JAPS01/4Axes_CNC_ESP32/ESPCNC Conexiones.pptx

CNC ESP32 BOARD

Vin 12V TO 60V

Pause

Micro SD-Card

USB C

End_Stop

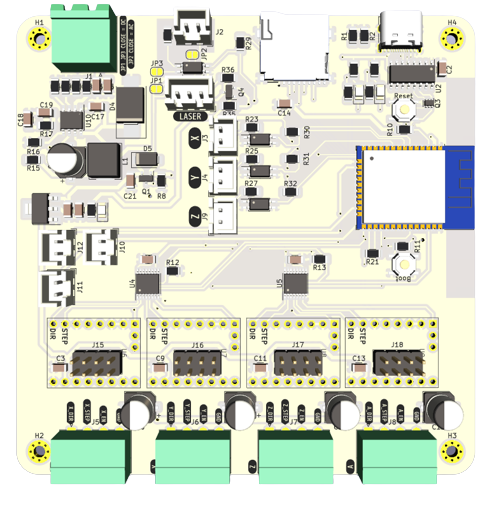
[picture p1: figure]

External Motor Driver MODE

IO12

IO13

IO15

X

Y

Z

A

DIR

STEP

EN

GND

DIR

STEP

EN

GND

DIR

STEP

EN

GND

DIR

STEP

EN

GND

## Slide 2

CNC ESP32 BOARD

Vin 12V TO 60V

Pause

Micro SD-Card

USB C

End_Stop

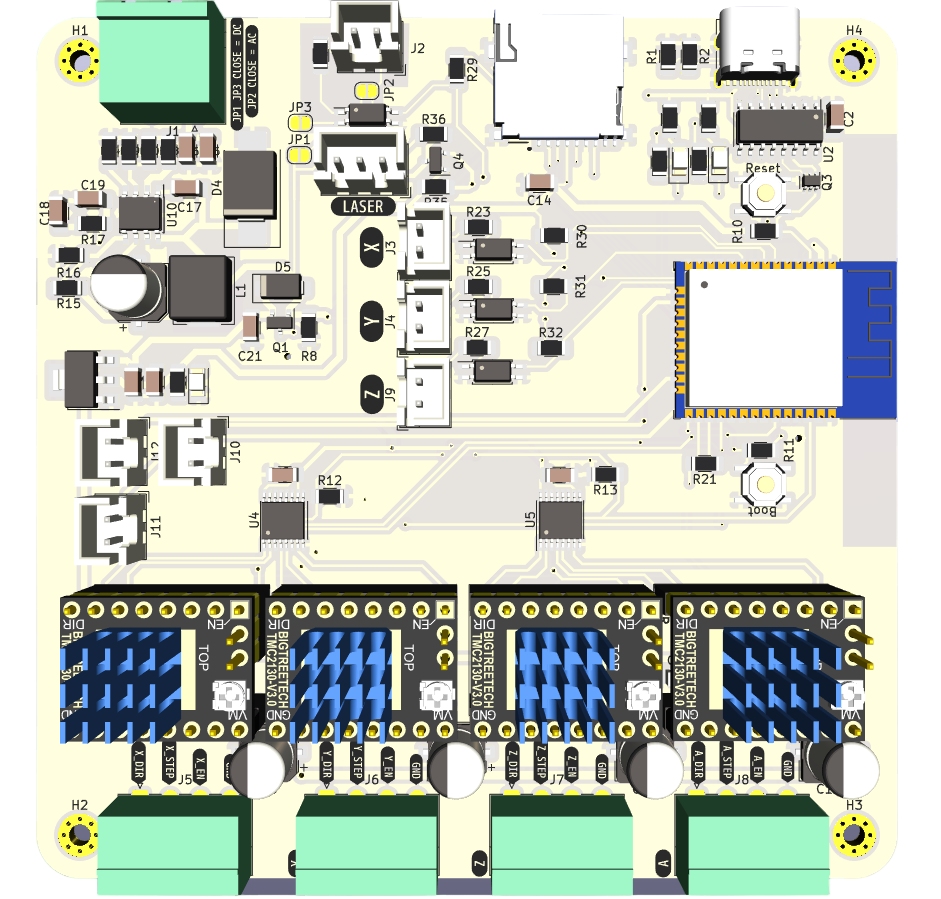
[picture p2: figure]

IO12

IO13

IO15

X

Y

Z

A

TMC2209 MODE

Step Motor
