JAPS01/4Axes_CNC_ESP32/DXF/80X80.dxf

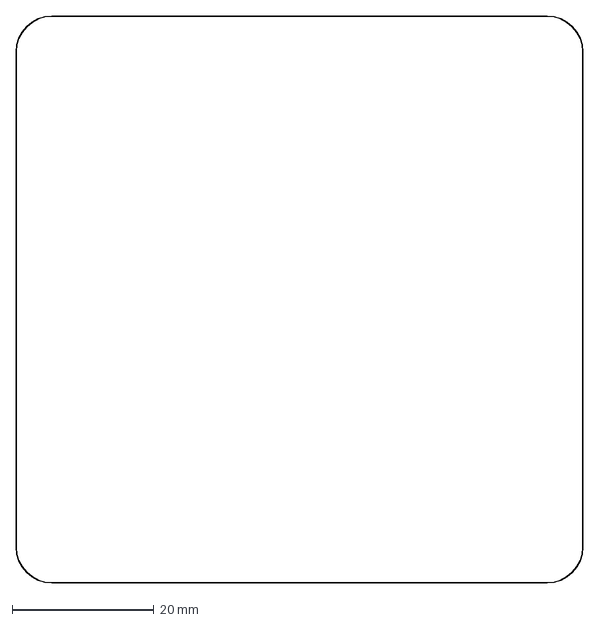
[picture p3: CAD file, 2023-11-01]
DXF/80X80.dxf
80.0 x 80.0 mm
