JAPS01/4Axes_CNC_ESP32/DXF/100X80.dxf

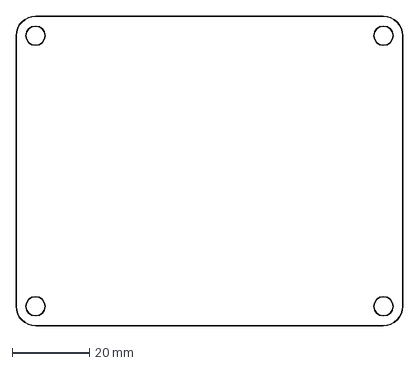
[picture p4: CAD file, 2023-11-01]
DXF/100X80.dxf
100.0 x 80.0 mm
