JAPS01/4Axes_CNC_ESP32/DXF/120X80.dxf

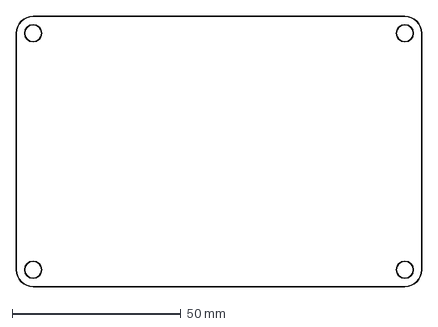
[picture p5: CAD file, 2023-11-01]
DXF/120X80.dxf
120.0 x 80.0 mm
