JAPS01/4Axes_CNC_ESP32/DXF/100X100.dxf

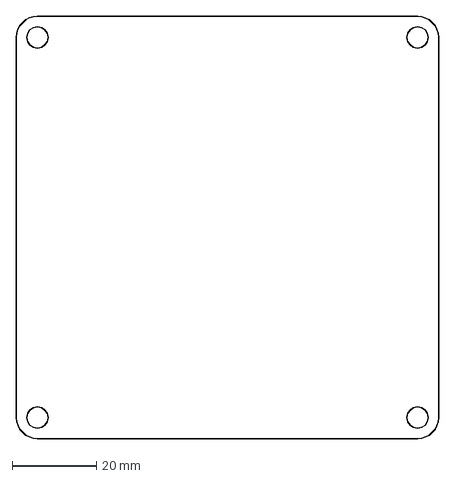
[picture p6: CAD file, 2023-11-01]
DXF/100X100.dxf
100.0 x 100.0 mm
