JAPS01/4Axes_CNC_ESP32/ESP32_CNC.kicad_pcb

## KiCad design ESP32_CNC.kicad_pcb (2023-11-01)

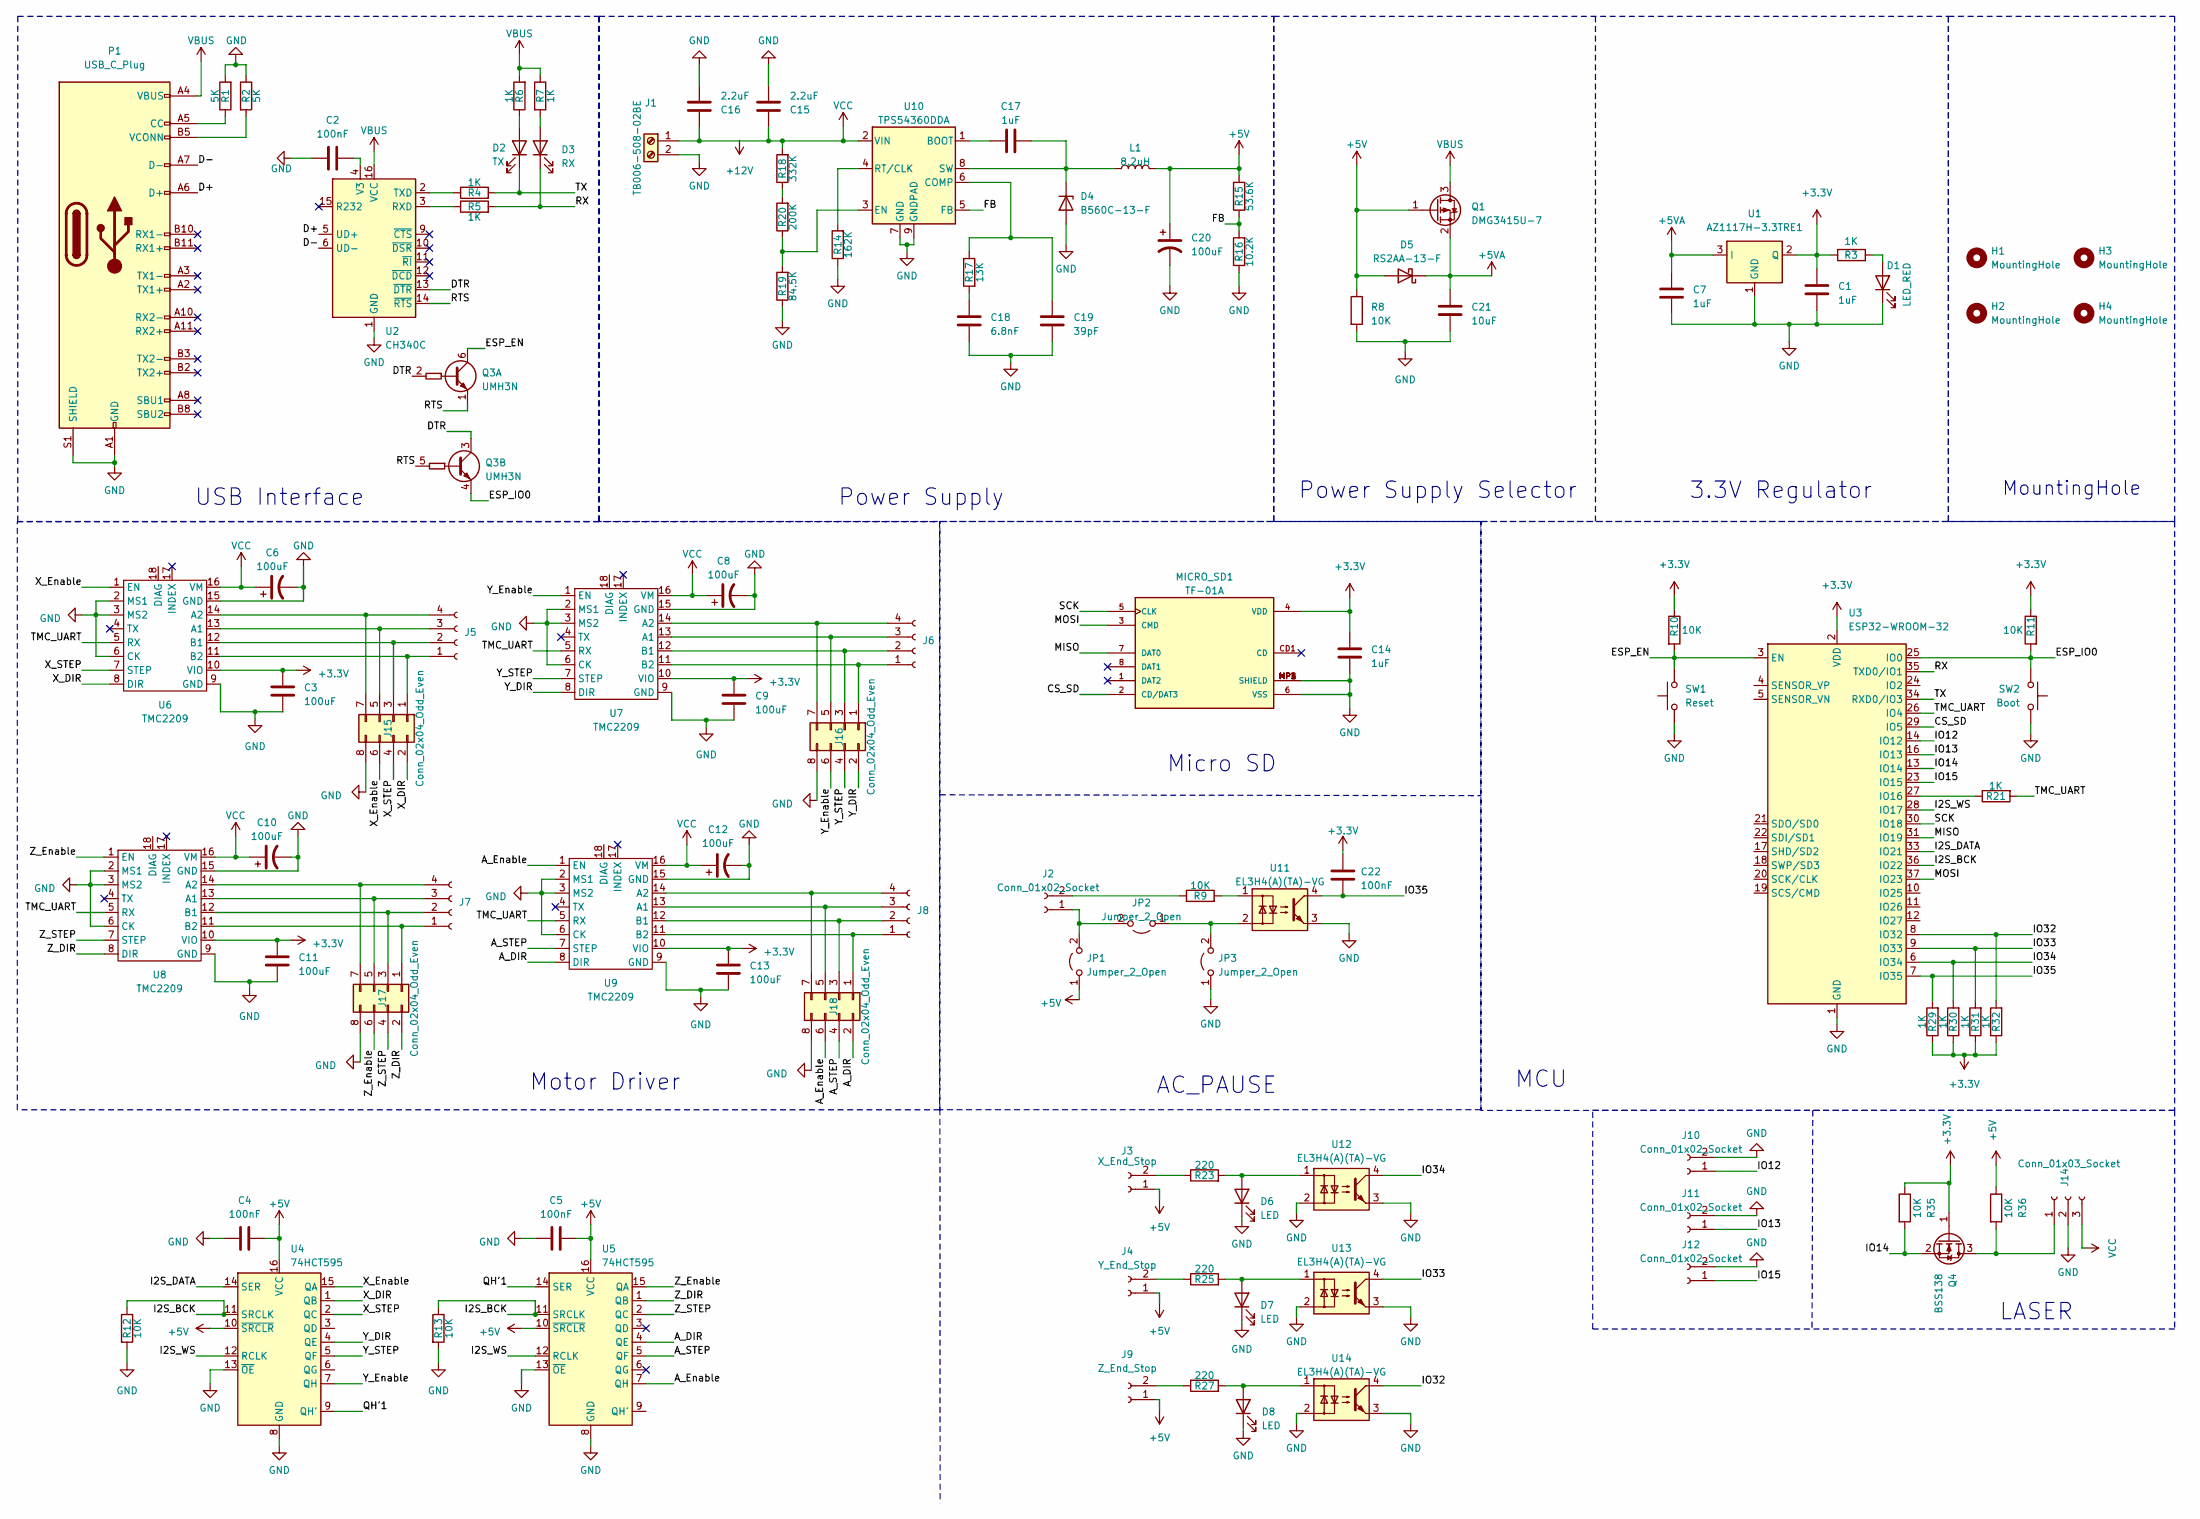
[picture p7: schematic ESP32_CNC.kicad_sch, ESP32_FLUID_BOARD]

Parts:
C1, C7, C14, C17: 1uF; C_1206_3216Metric_Pad1.33x1.80mm_HandSolder; LCSC C107185
C2, C4, C5, C22: 100nF; C_1206_3216Metric_Pad1.33x1.80mm_HandSolder; LCSC C82601
C3, C9, C11, C13: 100uF; C_1206_3216Metric_Pad1.33x1.80mm_HandSolder; LCSC C110048
C6, C8, C10, C12, C20: 100uF; CP_Elec_6.3x7.7; LCSC C178560
C15, C16: 2.2uF; C_1206_3216Metric_Pad1.33x1.80mm_HandSolder; LCSC C113893
C18: 6.8nF; C_1206_3216Metric_Pad1.33x1.80mm_HandSolder; LCSC C527325
C19: 39pF; C_1206_3216Metric_Pad1.33x1.80mm_HandSolder; LCSC C326958
C21: 10uF; C_1206_3216Metric_Pad1.33x1.80mm_HandSolder; LCSC C70462
D1: LED_RED; LED_1206_3216Metric_Pad1.42x1.75mm_HandSolder; LCSC C965827
D2: TX; LED_1206_3216Metric_Pad1.42x1.75mm_HandSolder; LCSC C965827
D3: RX; LED_1206_3216Metric_Pad1.42x1.75mm_HandSolder; LCSC C965827
D4: B560C-13-F; D_SMC_Handsoldering; LCSC C85100
D5: RS2AA-13-F; D_SMA
D6, D7, D8: LED; LED_1206_3216Metric_Pad1.42x1.75mm_HandSolder
H1, H2, H3, H4: MountingHole; MountingHole_2.5mm_Pad_Via
J1: TB006-508-02BE; PhoenixContact_MSTBA_2,5_2-G_1x02_P5.00mm_Horizontal; LCSC C505815
J2, J10, J11, J12: Conn_01x02_Socket; JST_XH_B2B-XH-A_1x02_P2.50mm_Vertical; LCSC C158012
J3: X_End_Stop; JST_XH_B2B-XH-A_1x02_P2.50mm_Vertical; LCSC C158012
J4: Y_End_Stop; JST_XH_B2B-XH-A_1x02_P2.50mm_Vertical; LCSC C158012
J5, J6, J7, J8: Conn_01x04_Socket; PhoenixContact_MC_1,5_4-G-3.5_1x04_P3.50mm_Horizontal; LCSC C441173
J9: Z_End_Stop; JST_XH_B2B-XH-A_1x02_P2.50mm_Vertical; LCSC C158012
J14: Conn_01x03_Socket; JST_XH_B3B-XH-A_1x03_P2.50mm_Vertical
J15, J16, J17, J18: Conn_02x04_Odd_Even; PinHeader_2x04_P2.54mm_Vertical
JP1, JP2, JP3: Jumper_2_Open; SolderJumper-2_P1.3mm_Open_RoundedPad1.0x1.5mm
L1: 8.2uH; L_Chilisin_BMRx00060630; LCSC C5349707
MICRO_SD1: TF-01A; LCSC C91145
P1: USB_C_Plug; USB_C_Receptacle_XKB_U262-16XN-4BVC11; LCSC C319148
Q1: DMG3415U-7; SOT-23; LCSC C96616
Q3: UMH3N; SOT-363_SC-70-6; LCSC C62892
Q4: BSS138; SOT-23
R1, R2: 5K; R_1206_3216Metric_Pad1.30x1.75mm_HandSolder; LCSC C870818
R3, R4, R5, R6, R7, R21, R29, R30, R31, R32: 1K; R_1206_3216Metric_Pad1.30x1.75mm_HandSolder; LCSC C112223
R8, R10, R11, R12, R13, R35, R36: 10K; R_1206_3216Metric_Pad1.30x1.75mm_HandSolder; LCSC C132649
R9: 10K; R_1206_3216Metric_Pad1.30x1.75mm_HandSolder
R14: 162K; R_1206_3216Metric_Pad1.30x1.75mm_HandSolder; LCSC C229338
R15: 53.6K; R_1206_3216Metric_Pad1.30x1.75mm_HandSolder; LCSC C229697
R16: 10.2K; R_1206_3216Metric_Pad1.30x1.75mm_HandSolder; LCSC C229274
R17: 13K; R_1206_3216Metric_Pad1.30x1.75mm_HandSolder; LCSC C229313
R18: 332K; R_1206_3216Metric_Pad1.30x1.75mm_HandSolder; LCSC C229555
R19: 84.5K; R_1206_3216Metric_Pad1.30x1.75mm_HandSolder; LCSC C229820
R20: 200K; R_1206_3216Metric_Pad1.30x1.75mm_HandSolder; LCSC C114937
R23, R25, R27: 220; R_1206_3216Metric_Pad1.30x1.75mm_HandSolder; LCSC C137176
SW1: Reset; JT1140; LCSC C465061
SW2: Boot; JT1140; LCSC C465061
U1: AZ1117H-3.3TRE1; SOT-223; LCSC C92517
U2: CH340C; SOIC-16_3.9x9.9mm_P1.27mm; LCSC C84681
U3: ESP32-WROOM-32
U4, U5: 74HCT595; TSSOP-16_4.4x5mm_P0.65mm; LCSC C842461
U6, U7, U8, U9: TMC2209
U10: TPS54360DDA; TI_SO-PowerPAD-8_ThermalVias; LCSC C44377
U11, U12, U13, U14: EL3H4(A)(TA)-VG; SOP-4_4.4x2.6mm_P1.27mm; LCSC C142289

Connections:
+3.3V: C1.1, C3.2, C9.2, C11.2, C13.2, C14.1, C22.2, MICRO_SD1.4 (VDD), Q4.1 (G), R3.1, R10.1, R11.1, R29.1, R30.1, R31.1, R32.1, R35.1, U1.2 (Q), U3.2 (VDD), U6.10 (VIO), U7.10 (VIO), U8.10 (VIO), U9.10 (VIO)
+5V: C4.2, C5.2, C20.1, D5.2 (A), J3.1, J4.1, J9.1, JP1.1 (A), L1.2, Q1.1 (G), R8.1, R15.2, R36.1, U4.10 (~SRCLR), U4.16 (VCC), U5.10 (~SRCLR), U5.16 (VCC)
+5VA: C7.1, C21.1, D5.1 (K), Q1.2 (S), U1.3 (I)
/A_DIR: J18.2, U5.4 (QE), U9.8 (DIR)
/A_Enable: J18.6, U5.7 (QH), U9.1 (EN)
/A_STEP: J18.4, U5.5 (QF), U9.7 (STEP)
/CS_SD: MICRO_SD1.2 (CD/DAT3), U3.29 (IO5)
/D+: P1.A6 (D+), U2.5 (UD+)
/D-: P1.A7 (D-), U2.6 (UD-)
/DTR: Q3.2 (B1), Q3.3 (C2), U2.13 (~DTR)
/ESP_EN: Q3.6 (C1), R10.2, SW1.2, U3.3 (EN)
/ESP_IO0: Q3.4 (E2), R11.2, SW2.2, U3.25 (IO0)
/FB: R15.1, R16.2, U10.5 (FB)
/I2S_BCK: R12.1, R13.1, U3.36 (IO22), U4.11 (SRCLK), U5.11 (SRCLK)
/I2S_DATA: U3.33 (IO21), U4.14 (SER)
/I2S_WS: U3.28 (IO17), U4.12 (RCLK), U5.12 (RCLK)
/IO12: J10.1, U3.14 (IO12)
/IO13: J11.1, U3.16 (IO13)
/IO14: Q4.2 (S), R35.2, U3.13 (IO14)
/IO15: J12.1, U3.23 (IO15)
/IO32: R32.2, U3.8 (IO32), U14.4
/IO33: R31.2, U3.9 (IO33), U13.4
/IO34: R30.2, U3.6 (IO34), U12.4
/IO35: C22.1, R29.2, U3.7 (IO35), U11.4
/MISO: MICRO_SD1.7 (DAT0), U3.31 (IO19)
/MOSI: MICRO_SD1.3 (CMD), U3.37 (IO23)
/QH'1: U4.9 (QH'), U5.14 (SER)
/RTS: Q3.1 (E1), Q3.5 (B2), U2.14 (~RTS)
/RX: D3.1 (K), R5.2, U3.35 (TXD0/IO1)
/SCK: MICRO_SD1.5 (CLK), U3.30 (IO18)
/TMC_UART: R21.2, U3.26 (IO4), U6.5 (RX), U7.5 (RX), U8.5 (RX), U9.5 (RX)
/TX: D2.1 (K), R4.2, U3.34 (RXD0/IO3)
/X_DIR: J15.2, U4.1 (QB), U6.8 (DIR)
/X_Enable: J15.6, U4.15 (QA), U6.1 (EN)
/X_STEP: J15.4, U4.2 (QC), U6.7 (STEP)
/Y_DIR: J16.2, U4.4 (QE), U7.8 (DIR)
/Y_Enable: J16.6, U4.7 (QH), U7.1 (EN)
/Y_STEP: J16.4, U4.5 (QF), U7.7 (STEP)
/Z_DIR: J17.2, U5.1 (QB), U8.8 (DIR)
/Z_Enable: J17.6, U5.15 (QA), U8.1 (EN)
/Z_STEP: J17.4, U5.2 (QC), U8.7 (STEP)
GND: C1.2, C2.1, C3.1, C4.1, C5.1, C6.2, C7.2, C8.2, C9.1, C10.2, C11.1, C12.2, C13.1, C14.2, C15.2, C16.2, C18.2, C19.1, C20.2, C21.2, D1.1 (K), D4.2 (A), D6.1 (K), D7.1 (K), D8.1 (K), J1.2, J10.2, J11.2, J12.2, J14.2, J15.8, J16.8, J17.8, J18.8, JP3.1 (A), MICRO_SD1.6 (VSS), MICRO_SD1.MP1 (SHIELD), MICRO_SD1.MP2 (SHIELD), MICRO_SD1.MP3 (SHIELD), MICRO_SD1.MP4 (SHIELD), P1.A1 (GND), P1.A12 (GND), P1.B1 (GND), P1.B12 (GND), P1.S1 (SHIELD), R1.2, R2.1, R8.2, R12.2, R13.2, R14.1, R16.1, R19.1, SW1.1, SW2.1, U1.1 (GND), U2.1 (GND), U3.1 (GND), U3.15 (GND), U3.38 (GND), U3.39 (GND), U4.8 (GND), U4.13 (~OE), U5.8 (GND), U5.13 (~OE), U6.2 (MS1), U6.3 (MS2), U6.6 (CK), U6.9 (GND), U6.15 (GND), U7.2 (MS1), U7.3 (MS2), U7.6 (CK), U7.9 (GND), U7.15 (GND), U8.2 (MS1), U8.3 (MS2), U8.6 (CK), U8.9 (GND), U8.15 (GND), U9.2 (MS1), U9.3 (MS2), U9.6 (CK), U9.9 (GND), U9.15 (GND), U10.7 (GND), U10.9 (GNDPAD), U11.3, U12.2, U12.3, U13.2, U13.3, U14.2, U14.3
unnamed: C18.1, R17.2
unnamed: D1.2 (A), R3.2
unnamed: D2.2 (A), R6.1
unnamed: D3.2 (A), R7.2
unnamed: C17.2, D4.1 (K), L1.1, U10.8 (SW)
unnamed: D6.2 (A), R23.2, U12.1
unnamed: D7.2 (A), R25.2, U13.1
unnamed: D8.2 (A), R27.2, U14.1
unnamed: J2.1, JP1.2 (B), JP2.2 (B)
unnamed: J2.2, R9.1
unnamed: J3.2, R23.1
unnamed: J4.2, R25.1
unnamed: J9.2, R27.1
unnamed: J14.1, Q4.3 (D), R36.2
unnamed: J5.1, J15.1, U6.11 (B2)
unnamed: J5.2, J15.3, U6.12 (B1)
unnamed: J5.3, J15.5, U6.13 (A1)
unnamed: J5.4, J15.7, U6.14 (A2)
unnamed: J6.1, J16.1, U7.11 (B2)
unnamed: J6.2, J16.3, U7.12 (B1)
unnamed: J6.3, J16.5, U7.13 (A1)
unnamed: J6.4, J16.7, U7.14 (A2)
unnamed: J7.1, J17.1, U8.11 (B2)
unnamed: J7.2, J17.3, U8.12 (B1)
unnamed: J7.3, J17.5, U8.13 (A1)
unnamed: J7.4, J17.7, U8.14 (A2)
unnamed: J8.1, J18.1, U9.11 (B2)
unnamed: J8.2, J18.3, U9.12 (B1)
unnamed: J8.3, J18.5, U9.13 (A1)
unnamed: J8.4, J18.7, U9.14 (A2)
unnamed: JP2.1 (A), JP3.2 (B), U11.2
unnamed: P1.A5 (CC), R1.1
unnamed: P1.B5 (VCONN), R2.2
unnamed: R9.2, U11.1
unnamed: R18.1, R20.2
unnamed: R5.1, U2.3 (RXD)
unnamed: R4.1, U2.2 (TXD)
unnamed: C2.2, U2.4 (V3)
unnamed: R21.1, U3.27 (IO16)
unnamed: C17.1, U10.1 (BOOT)
unnamed: C19.2, R17.1, U10.6 (COMP)
unnamed: R19.2, R20.1, U10.3 (EN)
unnamed: R14.2, U10.4 (RT/CLK)
VBUS: P1.A4 (VBUS), P1.A9 (VBUS), P1.B4 (VBUS), P1.B9 (VBUS), Q1.3 (D), R6.2, R7.1, U2.16 (VCC)
VCC: C6.1, C8.1, C10.1, C12.1, C15.1, C16.1, J1.1, J14.3, R18.2, U6.16 (VM), U7.16 (VM), U8.16 (VM), U9.16 (VM), U10.2 (VIN)

Notes on the sheet:
MCU
Motor Driver
AC_PAUSE
USB Interface
Micro SD
LASER
MountingHole
3.3V Regulator
Power Supply
Power Supply Selector

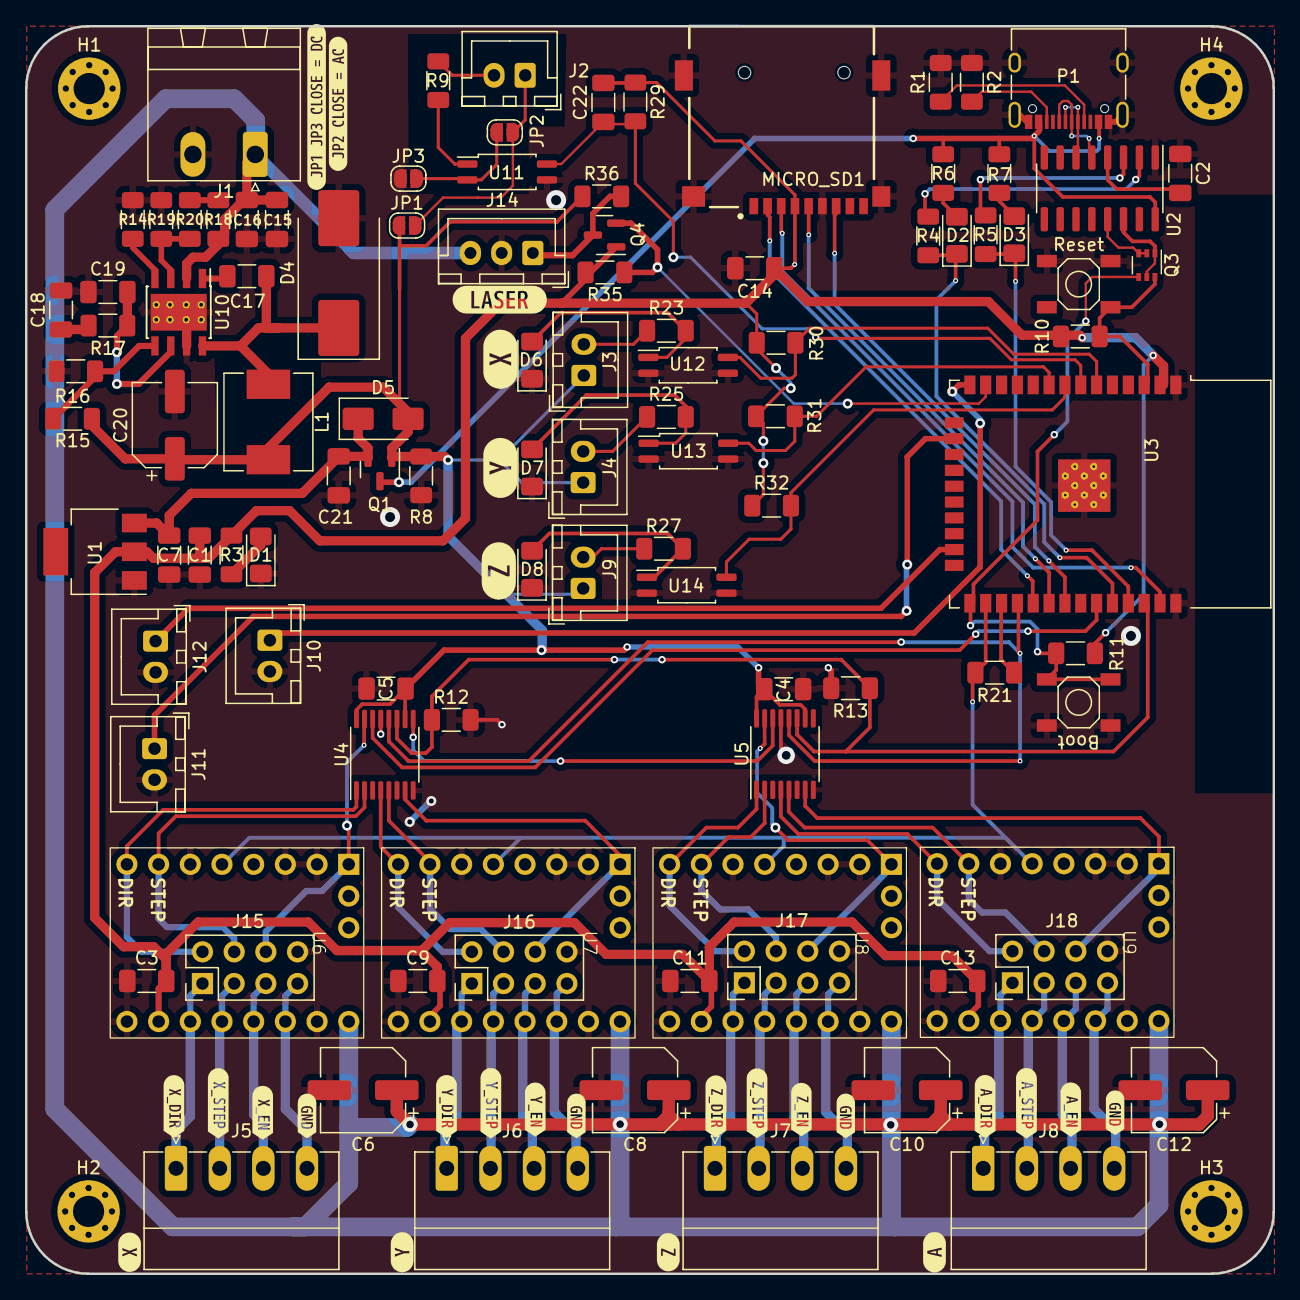
[picture p8: board ESP32_CNC.kicad_pcb from above]

Board: 2 copper layers, 100.0 x 100.0 mm, 132 parts (0 on the bottom side), 87 nets.

Other parts of the board:
kibuzzard-64A8D498: G***; kibuzzard-64A8D498
kibuzzard-64A9FD55: G***; kibuzzard-64A9FD55
kibuzzard-64A9FD75: G***; kibuzzard-64A9FD75
kibuzzard-64AA0C0E: G***; kibuzzard-64AA0C0E
kibuzzard-64AA0C1E: G***; kibuzzard-64AA0C1E
kibuzzard-64AA0C27: G***; kibuzzard-64AA0C27
kibuzzard-64AA3047: G***; kibuzzard-64AA3047
kibuzzard-64AF2DE8: G***; kibuzzard-64AF2DE8
kibuzzard-64AF2E2C: G***; kibuzzard-64AF2E2C
kibuzzard-64AF2E5B: G***; kibuzzard-64AF2E5B
kibuzzard-64AF2E13: G***; kibuzzard-64AF2E13
kibuzzard-64AF2E33, kibuzzard-64AF2E33#2, kibuzzard-64AF2E33#3, kibuzzard-64AF2E33#4: G***; kibuzzard-64AF2E33
kibuzzard-64AF2E65: G***; kibuzzard-64AF2E65
kibuzzard-64AF2EE8: G***; kibuzzard-64AF2EE8
kibuzzard-64AF2EF3: G***; kibuzzard-64AF2EF3
kibuzzard-64AF2EFB: G***; kibuzzard-64AF2EFB
kibuzzard-64AF2F0A: G***; kibuzzard-64AF2F0A
kibuzzard-64AF2F1D: G***; kibuzzard-64AF2F1D
kibuzzard-64AF2F02: G***; kibuzzard-64AF2F02
kibuzzard-64AF2F11: G***; kibuzzard-64AF2F11
kibuzzard-64AF2FB1: G***; kibuzzard-64AF2FB1
kibuzzard-64AF2FF1: G***; kibuzzard-64AF2FF1
kibuzzard-64AF3027: G***; kibuzzard-64AF3027
