JAPS01/4Axes_CNC_ESP32/firmware/Custom FluidNC/Config.yaml

name: "ESP32 Dev Controller V4"
board: "ESP32 Dev Controller V4"
meta: "update for 3.6.8"

stepping:
  engine: RMT
  idle_ms: 250
  dir_delay_us: 1
  pulse_us: 2
  disable_delay_us: 0
  
uart1:
  txd_pin: NO_PIN
  rxd_pin: gpio.16
  rts_pin: NO_PIN
  cts_pin: NO_PIN
  baud: 115200
  mode: 8N1

axes:
  shared_stepper_disable_pin: NO_PIN
  
  x:
    steps_per_mm: 800
    max_rate_mm_per_min: 5000
    acceleration_mm_per_sec2: 100
    max_travel_mm: 300
    homing:
      cycle: 1
      mpos_mm: 150
      positive_direction: false
      feed_mm_per_min: 100.000
      seek_mm_per_min: 200.000
      settle_ms: 500
    
    motor0:
      limit_neg_pin: gpio.34:low
      tmc_2209:
        uart_num: 1
        addr: 0
        cs_pin: NO_PIN
        r_sense_ohms: 0.110
        run_amps: 1.000
        hold_amps: 0.500
        microsteps: 16
        stallguard: 0
        stallguard_debug: false
        toff_disable: 0
        toff_stealthchop: 5
        toff_coolstep: 3
        run_mode: StealthChop
        homing_mode: StealthChop
        use_enable: false
        direction_pin: I2SO.1
        step_pin: I2SO.2
        disable_pin: I2SO.0:low

    motor1:
      null_motor:

  y:
    steps_per_mm: 100.000
    max_rate_mm_per_min: 5000.000
    acceleration_mm_per_sec2: 100.000
    max_travel_mm: 300.000
    soft_limits: false
    homing:
      cycle: 3
      positive_direction: false
      mpos_mm: 0.000
      feed_mm_per_min: 100.000
      seek_mm_per_min: 200.000
      settle_ms: 500
      seek_scaler: 1.100
      feed_scaler: 1.100

    motor0:
      limit_neg_pin: gpio.33:low
      limit_pos_pin: NO_PIN
      limit_all_pin: NO_PIN
      hard_limits: false
      pulloff_mm: 1.000
      standard_stepper:
        step_pin: I2SO.5
        direction_pin: I2SO.4
        disable_pin: I2SO.7:low

  z:
    steps_per_mm: 100.000
    max_rate_mm_per_min: 5000.000
    acceleration_mm_per_sec2: 100.000
    max_travel_mm: 150.000
    soft_limits: false
    homing:
      cycle: 1
      positive_direction: true
      mpos_mm: 150.000
      feed_mm_per_min: 100.000
      seek_mm_per_min: 800.000
      settle_ms: 500
      seek_scaler: 1.100
      feed_scaler: 1.100

    motor0:
      limit_neg_pin: gpio.32:low
      limit_pos_pin: NO_PIN
      limit_all_pin: NO_PIN
      hard_limits: false
      pulloff_mm: 1.000
      standard_stepper:
        step_pin: I2SO.10
        direction_pin: I2SO.9
        disable_pin: I2SO.8:low

  a:
    steps_per_mm: 100.000
    max_rate_mm_per_min: 5000.000
    acceleration_mm_per_sec2: 100.000
    max_travel_mm: 150.000
    soft_limits: false
    homing:
      cycle: 1
      positive_direction: true
      mpos_mm: 150.000
      feed_mm_per_min: 100.000
      seek_mm_per_min: 800.000
      settle_ms: 500
      seek_scaler: 1.100
      feed_scaler: 1.100

    motor0:
      limit_neg_pin: NO_PIN
      limit_pos_pin: NO_PIN
      limit_all_pin: NO_PIN
      hard_limits: false
      pulloff_mm: 1.000
      standard_stepper:
        step_pin: I2SO.13
        direction_pin: I2SO.12
        disable_pin: I2SO.15:low
      
i2so:
  bck_pin: gpio.22
  data_pin: gpio.21
  ws_pin: gpio.17

spi:
  miso_pin: gpio.19
  mosi_pin: gpio.23
  sck_pin: gpio.18

sdcard:
  card_detect_pin: NO_PIN
  cs_pin: gpio.5

start:
  must_home: false

control:
  safety_door_pin: gpio.35:high

Laser:
  pwm_hz: 5000
  output_pin: gpio.14
  enable_pin: NO_PIN
  disable_with_s0: false
  s0_with_disable: false
  tool_num: 0
  speed_map: 0=0.000% 255=100.000%
  off_on_alarm: true
