JAPS01/4Axes_CNC_ESP32/firmware/FluidNC-main/example_configs/3axis_v4.yaml

name: "ESP32 Dev Controller V4"
board: "ESP32 Dev Controller V4"

stepping:
  engine: RMT
  idle_ms: 250
  dir_delay_us: 1
  pulse_us: 2
  disable_delay_us: 0

axes:
  shared_stepper_disable_pin: gpio.13:low
  
  x:
    steps_per_mm: 800
    max_rate_mm_per_min: 2000
    acceleration_mm_per_sec2: 25
    max_travel_mm: 1000
    homing:
      cycle: 2
      mpos_mm: 10
      positive_direction: false
    
    motor0:
      limit_all_pin: gpio.17:low:pu
      stepstick:
        direction_pin: gpio.14
        step_pin: gpio.12
    motor1:
      null_motor:

  y:
    steps_per_mm: 800
    max_rate_mm_per_min: 2000
    acceleration_mm_per_sec2: 25
    max_travel_mm: 1000
    homing:
      cycle: 2
      mpos_mm: 10
      positive_direction: false

    motor0:
      limit_all_pin: gpio.4:low:pu
      stepstick:
        direction_pin: gpio.15
        step_pin: gpio.26
    motor1:
      null_motor:

  z:
    steps_per_mm: 800
    max_rate_mm_per_min: 2000
    acceleration_mm_per_sec2: 25
    max_travel_mm: 1000
    homing:
      cycle: 1
      mpos_mm: 10
      positive_direction: true

    motor0:
      limit_all_pin: gpio.16:low:pu
      stepstick:
        direction_pin: gpio.33
        step_pin: gpio.27
    motor1:
      null_motor:

spi:
  miso_pin: gpio.19
  mosi_pin: gpio.23
  sck_pin: gpio.18

sdcard:
  cs_pin: gpio.5
  card_detect_pin: NO_PIN

coolant:
  flood_pin: gpio.25
  mist_pin:  gpio.21

        
probe:
  pin: gpio.32:low:pu

PWM:
  pwm_hz: 5000
  output_pin: gpio.2
  enable_pin: gpio.22
  direction_pin: NO_PIN
  disable_with_s0: false
  s0_with_disable: true
  spinup_ms: 0
  spindown_ms: 0
  tool_num: 0
  speed_map: 0=0% 10000=100%
