JAPS01/4Axes_CNC_ESP32/firmware/FluidNC-main/example_configs/BlackBox_X32_XYYZ-DOOR.yaml

board: OpenBuilds BlackBox X32
name: BlackBox_X32_XYYZ-DOOR
meta: Handcrafted by Shell M Shrader
stepping:
  engine: RMT
  idle_ms: 255
  pulse_us: 2
  dir_delay_us: 1
  disable_delay_us: 0

axes:
  shared_stepper_disable_pin: gpio.17:low
  x:
    steps_per_mm: 200.000
    max_rate_mm_per_min: 1000.000
    acceleration_mm_per_sec2: 100.000
    max_travel_mm: 300.000
    soft_limits: false
    homing:
      cycle: 2
      feed_mm_per_min: 100.000
      seek_mm_per_min: 500.000
      settle_ms: 500
      seek_scaler: 1.100
      feed_scaler: 1.100

    motor0:
      limit_neg_pin: gpio.35
      limit_pos_pin: NO_PIN
      limit_all_pin: NO_PIN
      hard_limits: false
      pulloff_mm: 1.000
      standard_stepper:
        step_pin: gpio.12
        direction_pin: gpio.14

  y:
    steps_per_mm: 200.000
    max_rate_mm_per_min: 1000.000
    acceleration_mm_per_sec2: 100.000
    max_travel_mm: 300.000
    soft_limits: false
    homing:
      cycle: 2
      feed_mm_per_min: 100.000
      seek_mm_per_min: 500.000
      settle_ms: 500
      seek_scaler: 1.100
      feed_scaler: 1.100

    motor0:
      limit_neg_pin: gpio.34
      limit_pos_pin: NO_PIN
      limit_all_pin: NO_PIN
      hard_limits: false
      pulloff_mm: 1.000
      standard_stepper:
        step_pin: gpio.27
        direction_pin: gpio.26

    motor1:
      standard_stepper:
        step_pin: gpio.33
        direction_pin: gpio.32

  z:
    steps_per_mm: 200.000
    max_rate_mm_per_min: 300.000
    acceleration_mm_per_sec2: 100.000
    max_travel_mm: 50.000
    soft_limits: false
    homing:
      cycle: 1
      feed_mm_per_min: 100.000
      seek_mm_per_min: 200.000
      settle_ms: 500
      seek_scaler: 1.100
      feed_scaler: 1.100

    motor0:
      limit_neg_pin: gpio.39
      limit_pos_pin: NO_PIN
      limit_all_pin: NO_PIN
      hard_limits: false
      pulloff_mm: 1.000
      standard_stepper:
        step_pin: gpio.15
        direction_pin: gpio.2

spi:
  miso_pin: gpio.19
  mosi_pin: gpio.23
  sck_pin: gpio.18

sdcard:
  card_detect_pin: NO_PIN
  cs_pin: gpio.5

probe:
  pin: gpio.22:low
  check_mode_start: true

control:
  safety_door_pin: gpio.16:pu

macros:
  startup_line0:
  startup_line1:
  macro0:
  macro1:
  macro2:
  macro3:

start:
  must_home: false

coolant:
  mist_pin: gpio.21
  delay_ms: 0

PWM:
  pwm_hz: 5000
  output_pin: gpio.25
  enable_pin: gpio.13
  direction_pin: gpio.4
  disable_with_s0: false
  s0_with_disable: true
  spinup_ms: 30000
  spindown_ms: 10000
  tool_num: 0
  speed_map: 0=0.000% 1000=100.000%
