JAPS01/4Axes_CNC_ESP32/firmware/FluidNC-main/example_configs/test_drive_SD.yaml

board: None
name: Default (Test Drive)
stepping:
  engine: RMT
  idle_ms: 255
  pulse_us: 4
  dir_delay_us: 0
  disable_delay_us: 0

axes:
  shared_stepper_disable_pin: NO_PIN
  x:
    steps_per_mm: 320.000
    max_rate_mm_per_min: 1000.000
    acceleration_mm_per_sec2: 25.000
    max_travel_mm: 200.000
    soft_limits: false

  y:
    steps_per_mm: 320.000
    max_rate_mm_per_min: 1000.000
    acceleration_mm_per_sec2: 25.000
    max_travel_mm: 200.000
    soft_limits: false

  z:
    steps_per_mm: 320.000
    max_rate_mm_per_min: 1000.000
    acceleration_mm_per_sec2: 25.000
    max_travel_mm: 200.000
    soft_limits: false

spi:
  miso_pin: NO_PIN
  mosi_pin: NO_PIN
  sck_pin: NO_PIN


probe:
  pin: NO_PIN
  check_mode_start: true

macros:
  startup_line0:
  startup_line1:
  macro0:
  macro1:
  macro2:
  macro3:

sdcard:
  card_detect_pin: NO_PIN
  cs_pin: gpio.5

NoSpindle:
