JAPS01/4Axes_CNC_ESP32/firmware/FluidNC-main/FluidNC/test/Pins/Undefined.cpp

#include "../TestFramework.h"

#include <src/Pin.h>

namespace Pins {
    Test(Undefined, Pins) {
        // Unassigned pins are not doing much...

        Pin unassigned;
        Assert(Pin() == unassigned, "Undefined has wrong pin id");

        {
            unassigned.write(true);
            auto result = unassigned.read();
            Assert(0 == result, "Result value incorrect");
        }

        {
            unassigned.write(false);
            auto result = unassigned.read();
            Assert(0 == result, "Result value incorrect");
        }

        AssertThrow(unassigned.attachInterrupt([](void* arg) {}, EITHER_EDGE));
        AssertThrow(unassigned.detachInterrupt());

        Assert(unassigned.capabilities().has(Pin::Capabilities::Void));
        auto name = unassigned.name();
        Assert(unassigned.name().equals("NO_PIN"));
    }

    Test(Undefined, MultipleInstances) {
        {
            Pin unassigned;
            Pin unassigned2;

            Assert(unassigned == unassigned2, "Should evaluate to true.");
        }

        {
            Pin unassigned = Pin();
            Pin unassigned2;

            Assert(unassigned == unassigned2, "Should evaluate to true.");
        }

        {
            Pin unassigned = Pin::create("void.2");
            Pin unassigned2;

            Assert(unassigned != unassigned2, "Second void pin should match first.");
        }

        {
            Pin unassigned  = Pin::create("void.2");
            Pin unassigned2 = Pin::create("void.2");

            Assert(unassigned != unassigned2, "Second void pin should not match first.");
        }
    }
}
