JAPS01/4Axes_CNC_ESP32/firmware/FluidNC-main/X86TestSupport/TestSupport/Esp.h

#pragma once

#include <cstdint>

typedef enum {
    ESP_RST_UNKNOWN,    //!< Reset reason can not be determined
    ESP_RST_POWERON,    //!< Reset due to power-on event
    ESP_RST_EXT,        //!< Reset by external pin (not applicable for ESP32)
    ESP_RST_SW,         //!< Software reset via esp_restart
    ESP_RST_PANIC,      //!< Software reset due to exception/panic
    ESP_RST_INT_WDT,    //!< Reset (software or hardware) due to interrupt watchdog
    ESP_RST_TASK_WDT,   //!< Reset due to task watchdog
    ESP_RST_WDT,        //!< Reset due to other watchdogs
    ESP_RST_DEEPSLEEP,  //!< Reset after exiting deep sleep mode
    ESP_RST_BROWNOUT,   //!< Brownout reset (software or hardware)
    ESP_RST_SDIO,       //!< Reset over SDIO
} esp_reset_reason_t;

esp_reset_reason_t esp_reset_reason(void);

struct EspClass {
    uint64_t    getEfuseMac();
    uint32_t    getCpuFreqMHz();
    const char* getSdkVersion();
    uint32_t    getFreeHeap();
    uint32_t    getFlashChipSize();

    void restart();
};
extern EspClass ESP;

inline long map(long x, long in_min, long in_max, long out_min, long out_max) {
    return (x - in_min) * (out_max - out_min) / (in_max - in_min) + out_min;
}

int temperatureRead(void);
